Neurotech-Hub/ColorimeterLoadSuite/(commit log)

2026-09-16 Add three-sector load cell control panel.
    Desktop GUI with serial connect, donut/pressure view, smoothed time series, and baseline subtraction.
2026-09-17 Ship calibrated gram load stream, session CSV recording, and DSEG readout.
    Firmware averages ADC over 50 ms and converts to grams; the GUI drops baseline/smoothing, adds session save controls, and vendors a 7-segment font.
2026-09-17 Expand the README for end users and add a GUI screenshot.
    Document Raven, FSP03CE, circuit, install steps, and link the Fusion 360 design with docs/load_gui.png.
2026-09-17 photo and materials to readme
